JacksonAkt/3D-Robot-Arm-/Systems/Raw-Schematics.png

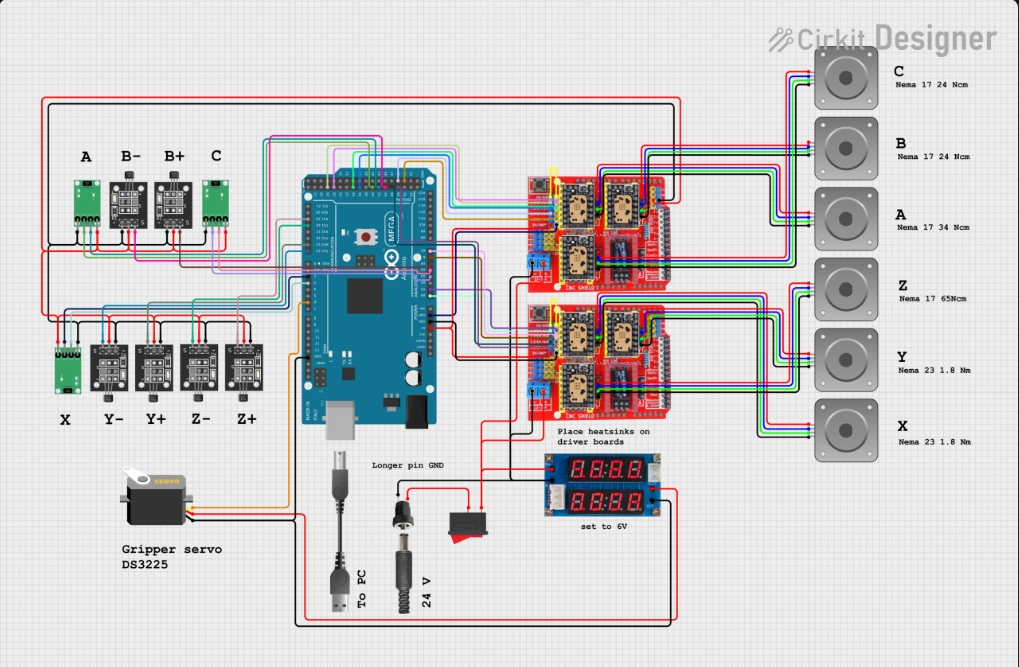
Systems/Raw-Schematics.png
