JacksonAkt/3D-Robot-Arm-/Systems/Wiring-Prototype.jpg

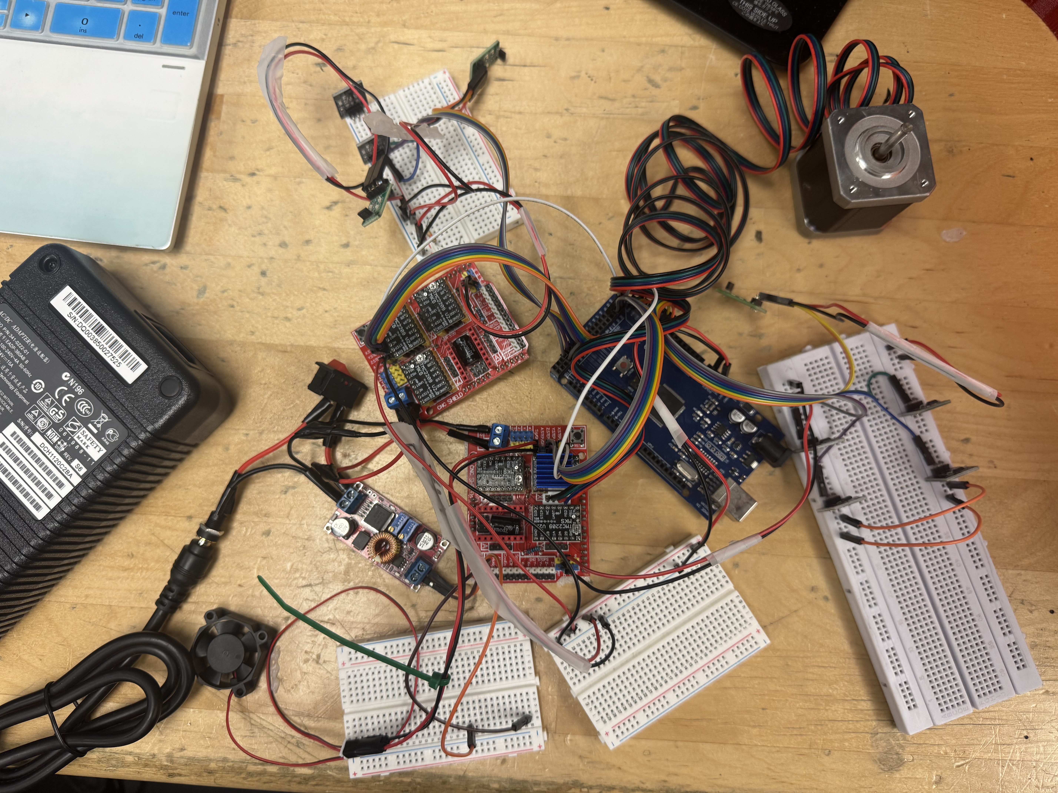
Systems/Wiring-Prototype.jpg
