JacksonAkt/3D-Robot-Arm-/PCB/Layout1.png

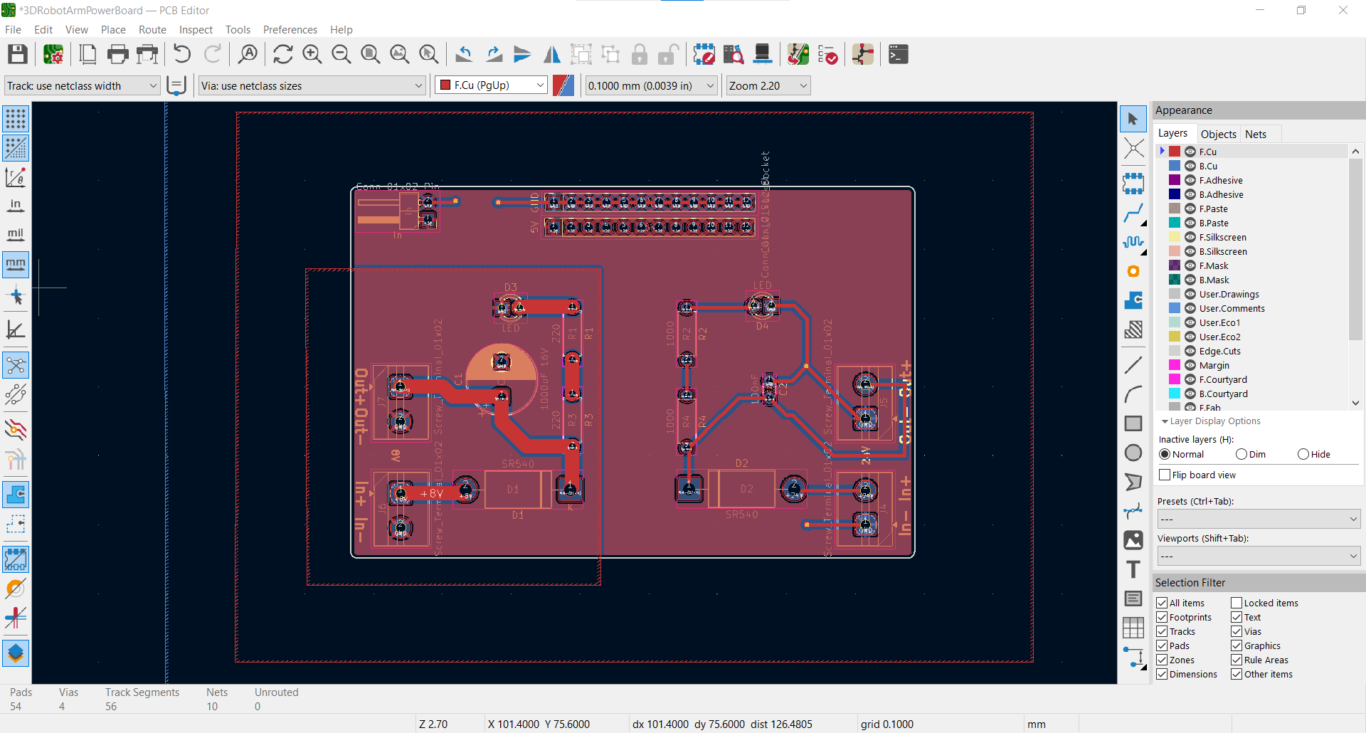
PCB/Layout1.png
