JacksonAkt/3D-Robot-Arm-/PCB/Layout2.png

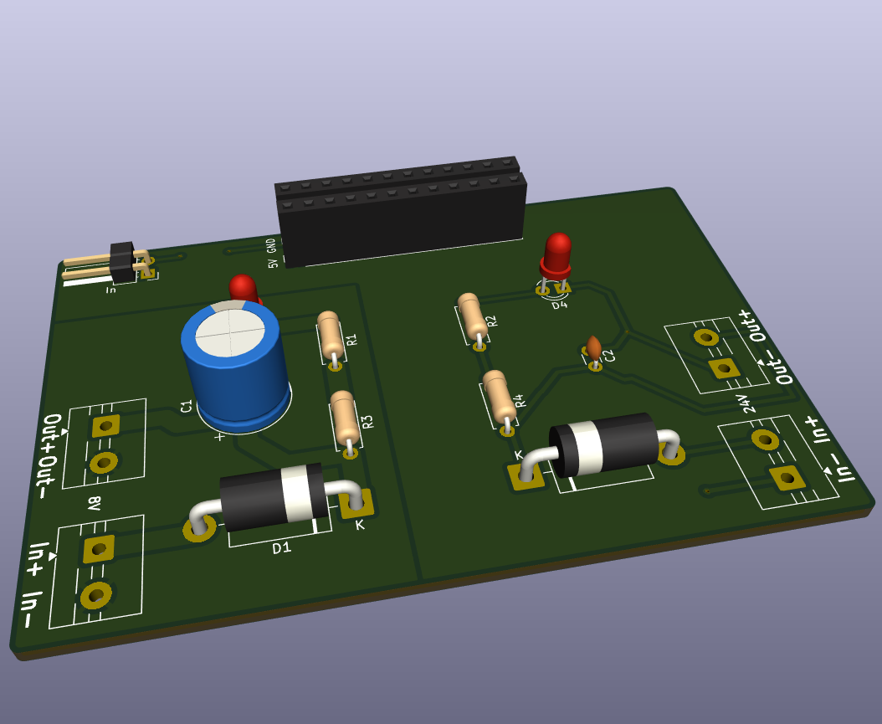
PCB/Layout2.png
