JacksonAkt/3D-Robot-Arm-/PCB/PCB.jpeg

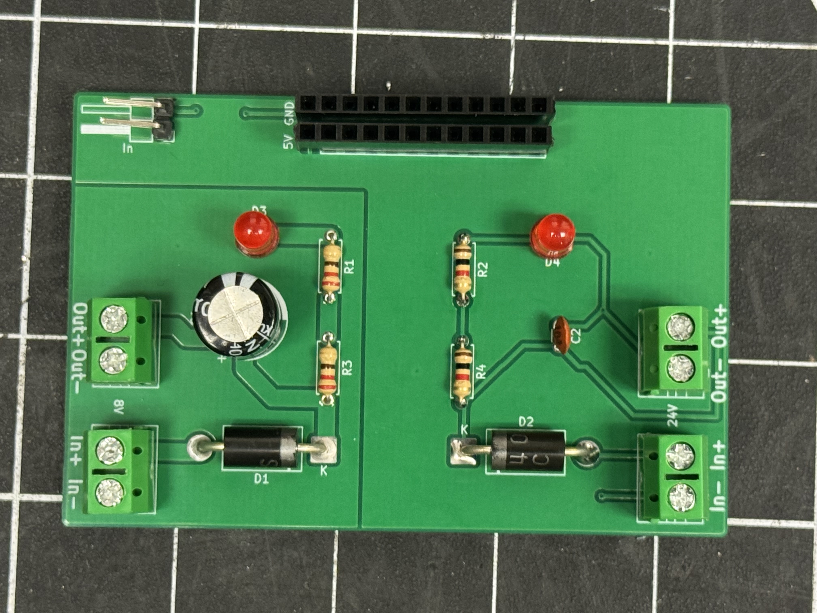
PCB/PCB.jpeg
