JacksonAkt/3D-Robot-Arm-/PCB/Raw-Schematics.png

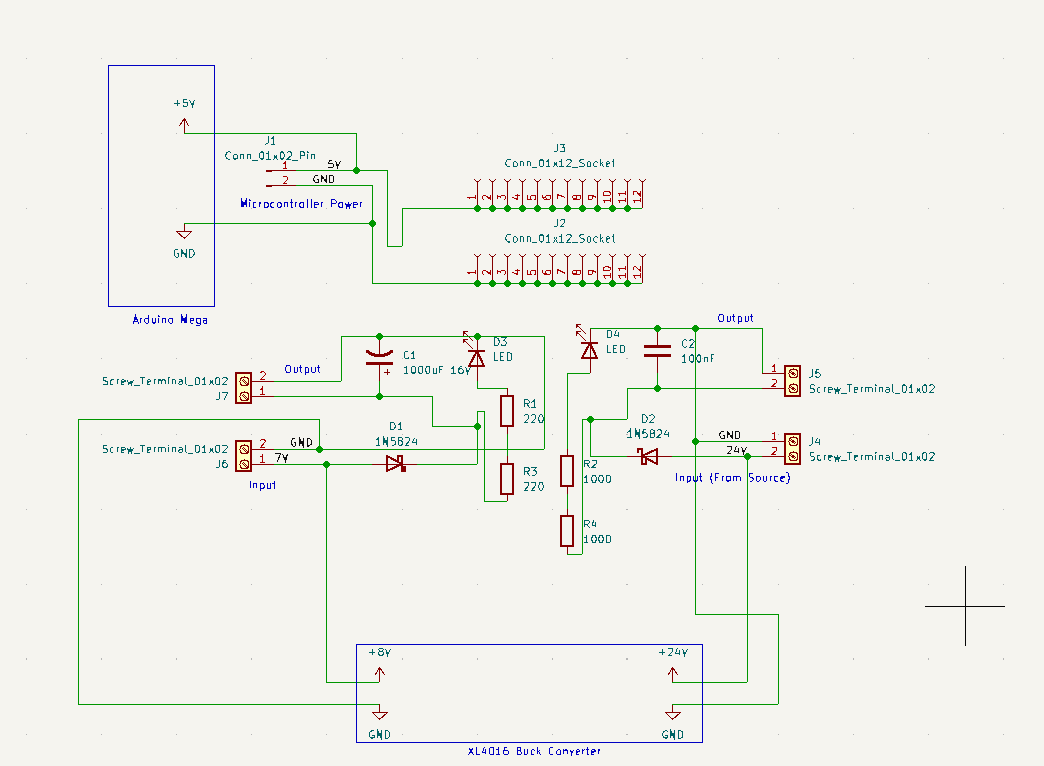
PCB/Raw-Schematics.png
