JacksonAkt/3D-Robot-Arm-/PCB/Schematics.png

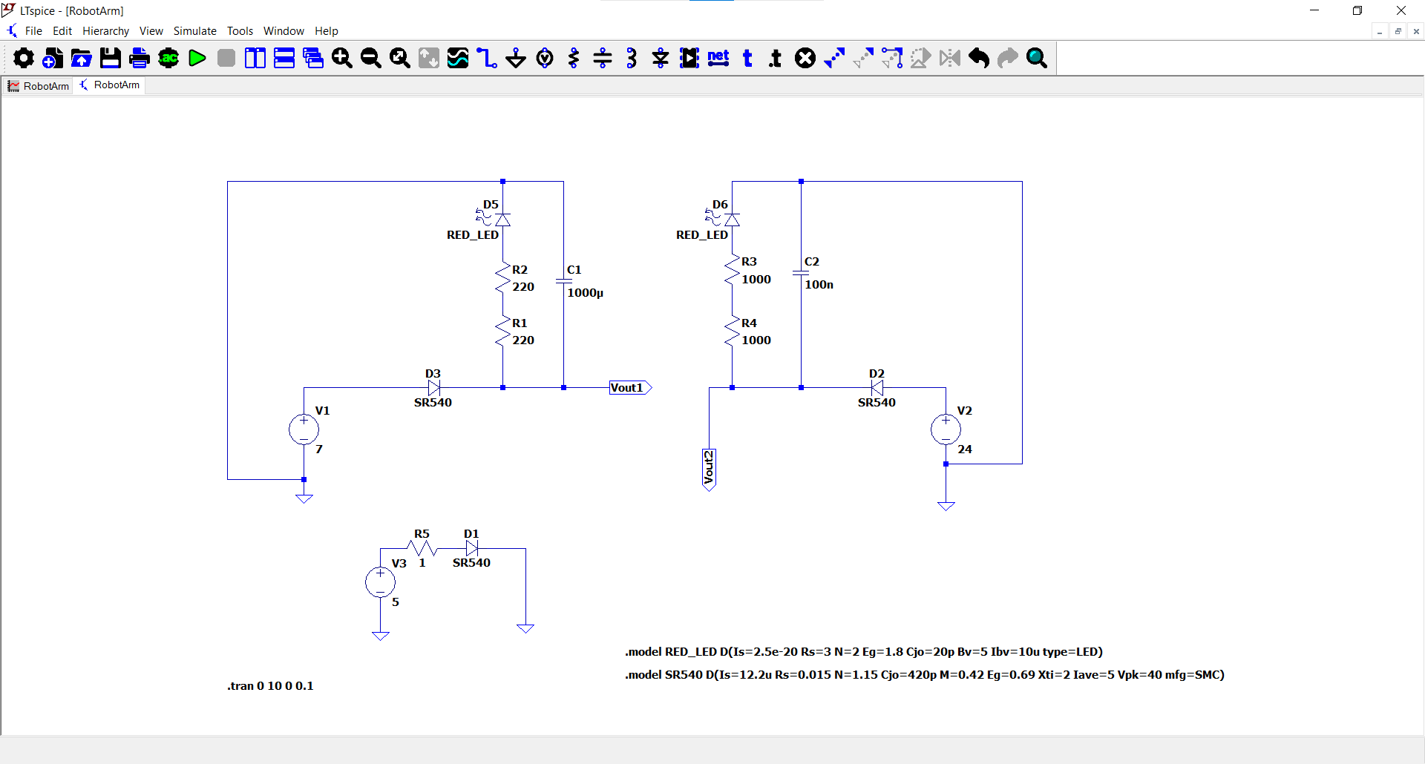
PCB/Schematics.png
