JacksonAkt/3D-Robot-Arm-/PCB/Stimulation.png

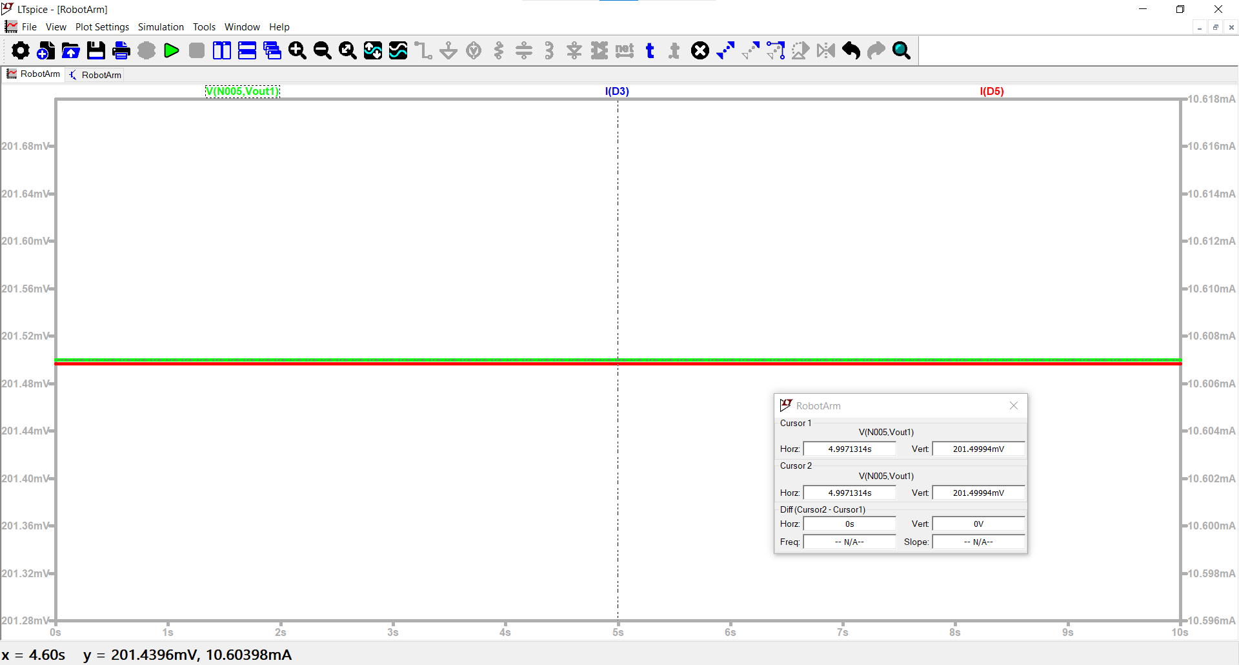
PCB/Stimulation.png
