JacksonAkt/3D-Robot-Arm-/Systems/Cooked Schematics.png

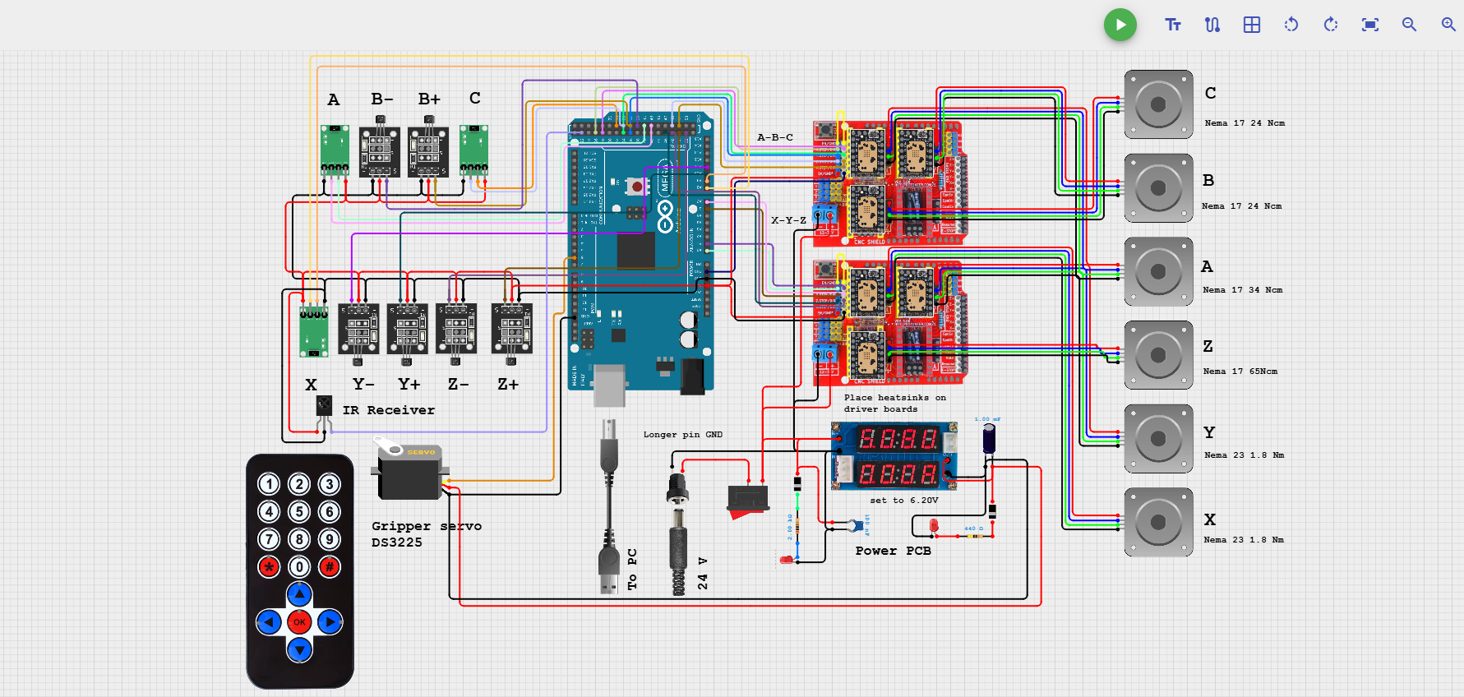
Systems/Cooked Schematics.png
