JacksonAkt/3D-Robot-Arm-/PCB/BOM.xlsx

Reference | Qty | Value | DNP | Exclude from BOM | Exclude from Board | Footprint | Datasheet | Price | Purchase
C1 | 1 | 1000uF 16V |  |  |  | Capacitor_THT:CP_Radial_D10.0mm_P2.50mm | ~ |  | Available
C2 | 1 | 100nF |  |  |  | Capacitor_THT:C_Disc_D5.0mm_W2.5mm_P5.00mm | ~ |  | Available
D1,D2 | 2 | SR540 |  |  |  | Diode_THT:D_DO-201AD_P15.24mm_Horizontal | http://www.vishay.com/docs/88526/1n5820.pdf | 5.99 | https://www.amazon.com/20-Pieces-SR540-Schottky-Rectifier/dp/B079KDRFY7
D3,D4 | 2 | LED |  |  |  | LED_THT:LED_D3.0mm | ~ |  | Available
J1 | 1 | Conn_01x02_Pin |  |  |  | Connector_PinHeader_2.54mm:PinHeader_1x02_P2.54mm_Horizontal | ~ |  | Available
J2,J3 | 2 | Conn_01x12_Socket |  |  |  | Connector_PinSocket_2.54mm:PinSocket_1x12_P2.54mm_Vertical | ~ | 4.99 | https://www.amazon.com/QSYZAIL-Right-Angle-Connector-Compatible-Breadboard/dp/B0G56RWP5D
J4,J5,J6,J7 | 4 | Screw_Terminal_01x02 |  |  |  | TerminalBlock:TerminalBlock_MaiXu_MX126-5.0-02P_1x02_P5.00mm | ~ | 5.49 | https://www.amazon.com/Screw-Terminal-Block-Circuit-Connectors/dp/B0FNQX9MMT
R1,R3 | 2 | 220 |  |  |  | Resistor_THT:R_Axial_DIN0207_L6.3mm_D2.5mm_P7.62mm_Horizontal | ~ |  | Available
R2,R4 | 2 | 1000 |  |  |  | Resistor_THT:R_Axial_DIN0207_L6.3mm_D2.5mm_P7.62mm_Horizontal | ~ |  | Available
PCB | 5
 |  |  |  |  |  |  |  | 16.47
