JacksonAkt/3D-Robot-Arm-/(commit log)

2026-07-03 Revise README for 3D Robot Arm project details
    Updated the README to provide a comprehensive overview of the 3D Robot Arm project, including mechanical production, electrical systems, PCB design, and software details.
2026-07-03 Update project
    [BOM.xlsx]
2026-07-22 Enhance README with PCB image and weight details
    Added an image of the completed PCB and updated the weight reduction information.
