JacksonAkt/3D-Robot-Arm-/Systems/Image.jpg

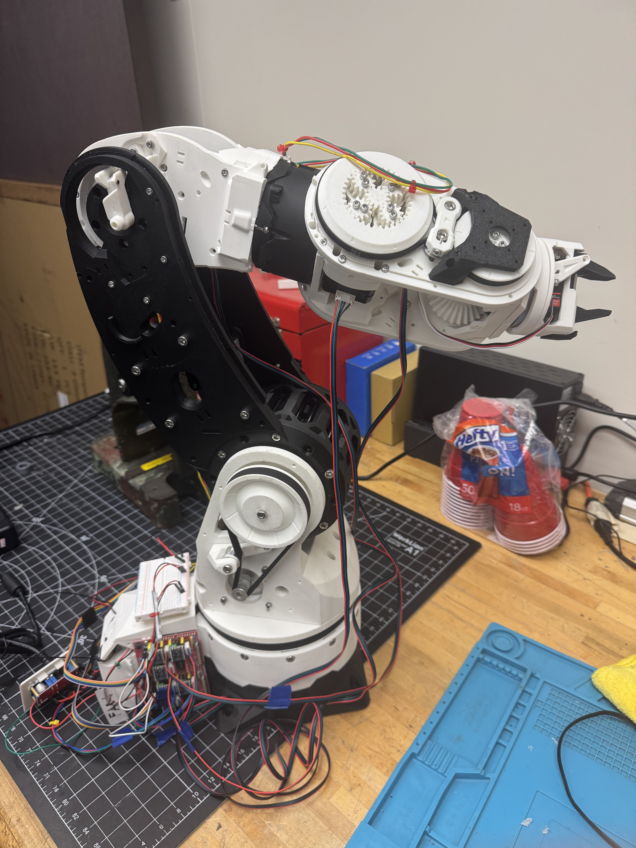
Systems/Image.jpg
